klh/microrack/bambuu_print.3mf

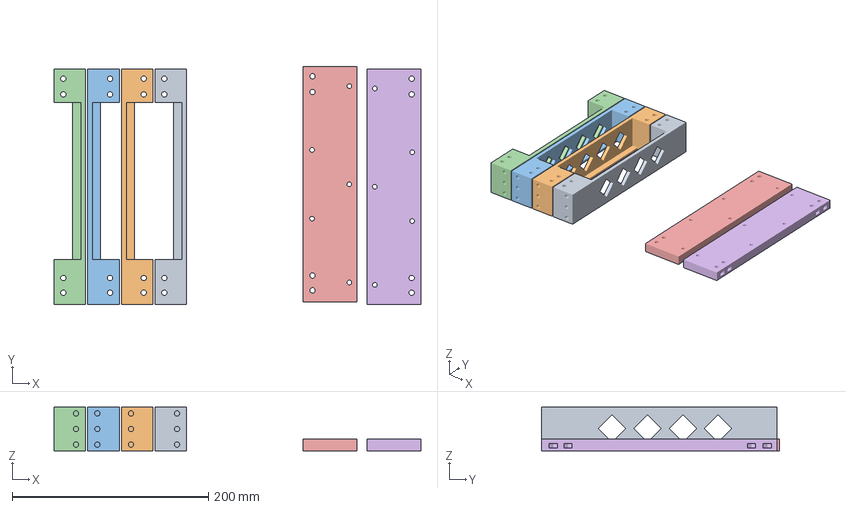
[picture p3: CAD file, 2026-10-18]
bambuu_print.3mf
373.8 x 242.4 x 44.5 mm
side_left.stl x 2
side_right.stl x 2
top_left.stl
top_right.stl
