klh/microrack/side_right.stl

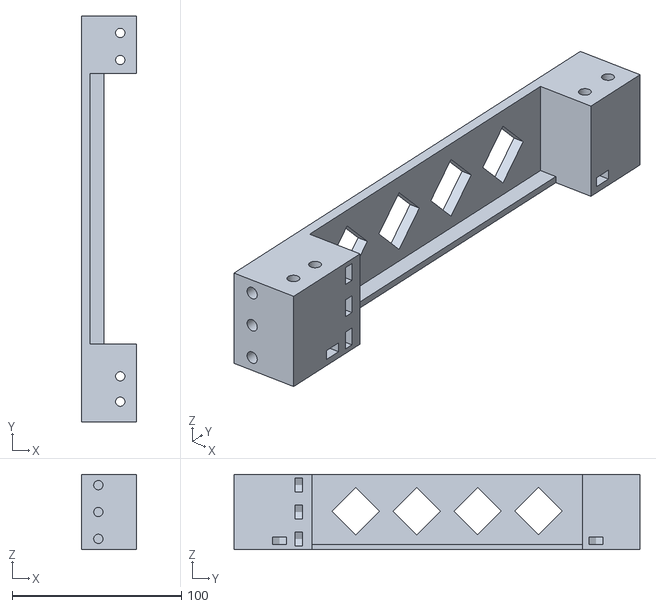
[picture p4: CAD file, 2026-10-18]
side_right.stl
32.3 x 240.0 x 44.5
