klh/microrack/top_left.stl

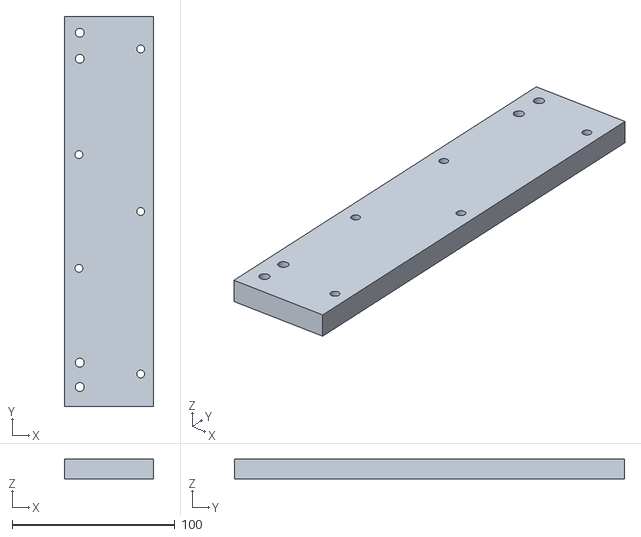
[picture p5: CAD file, 2026-10-18]
top_left.stl
55.0 x 240.0 x 12.0
