klh/microrack/(list of files, cad)

Other CAD files:
side_left.stl
top_right.stl
