klh/microrack/kit_assembly.png

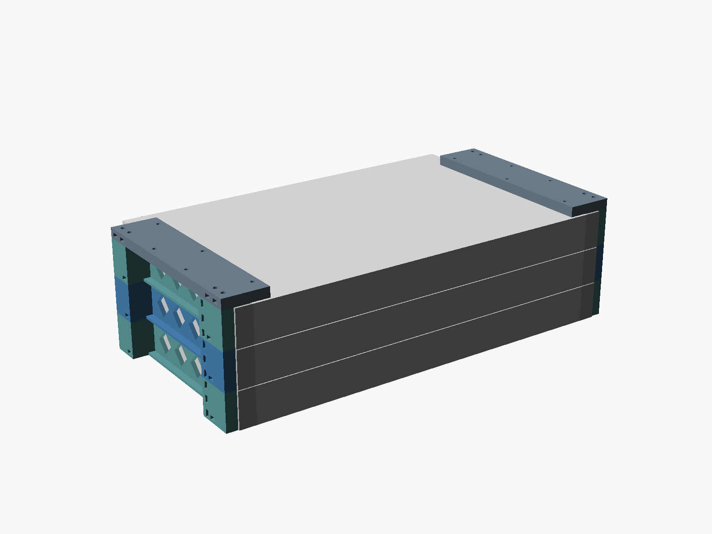
kit_assembly.png
